averia/ArdCore/README.md

ArdCore, based on a project by www.20objects.com

ardcore_pcb
