averia/ArdCore/hardware/ardcore_V1/ardcore_esquematico.png

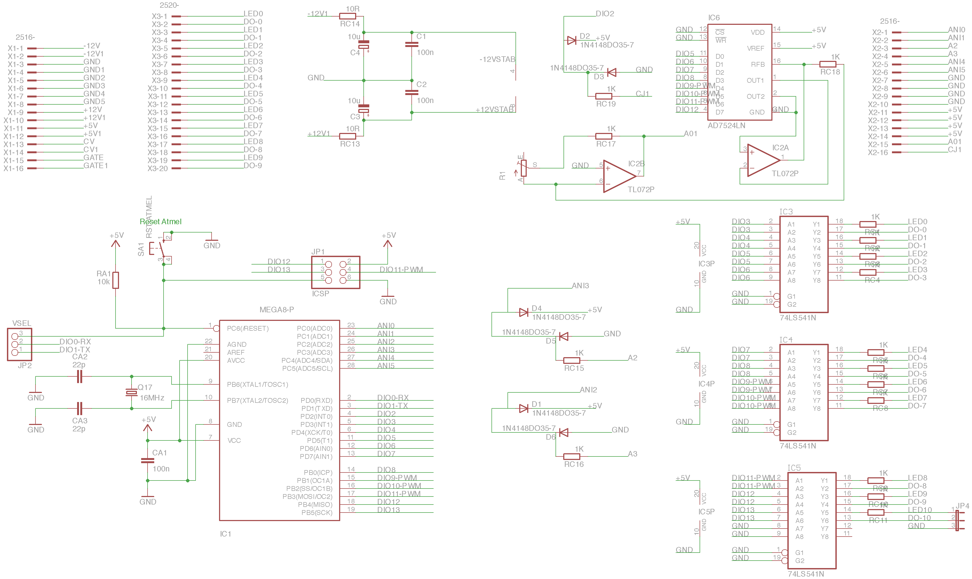
hardware/ardcore_V1/ardcore_esquematico.png
