averia/ArdCore/hardware/ardcore_V1/ardcore_V1.brd

## EAGLE design hardware/ardcore_V1/ardcore_V1.brd (2017-08-19)

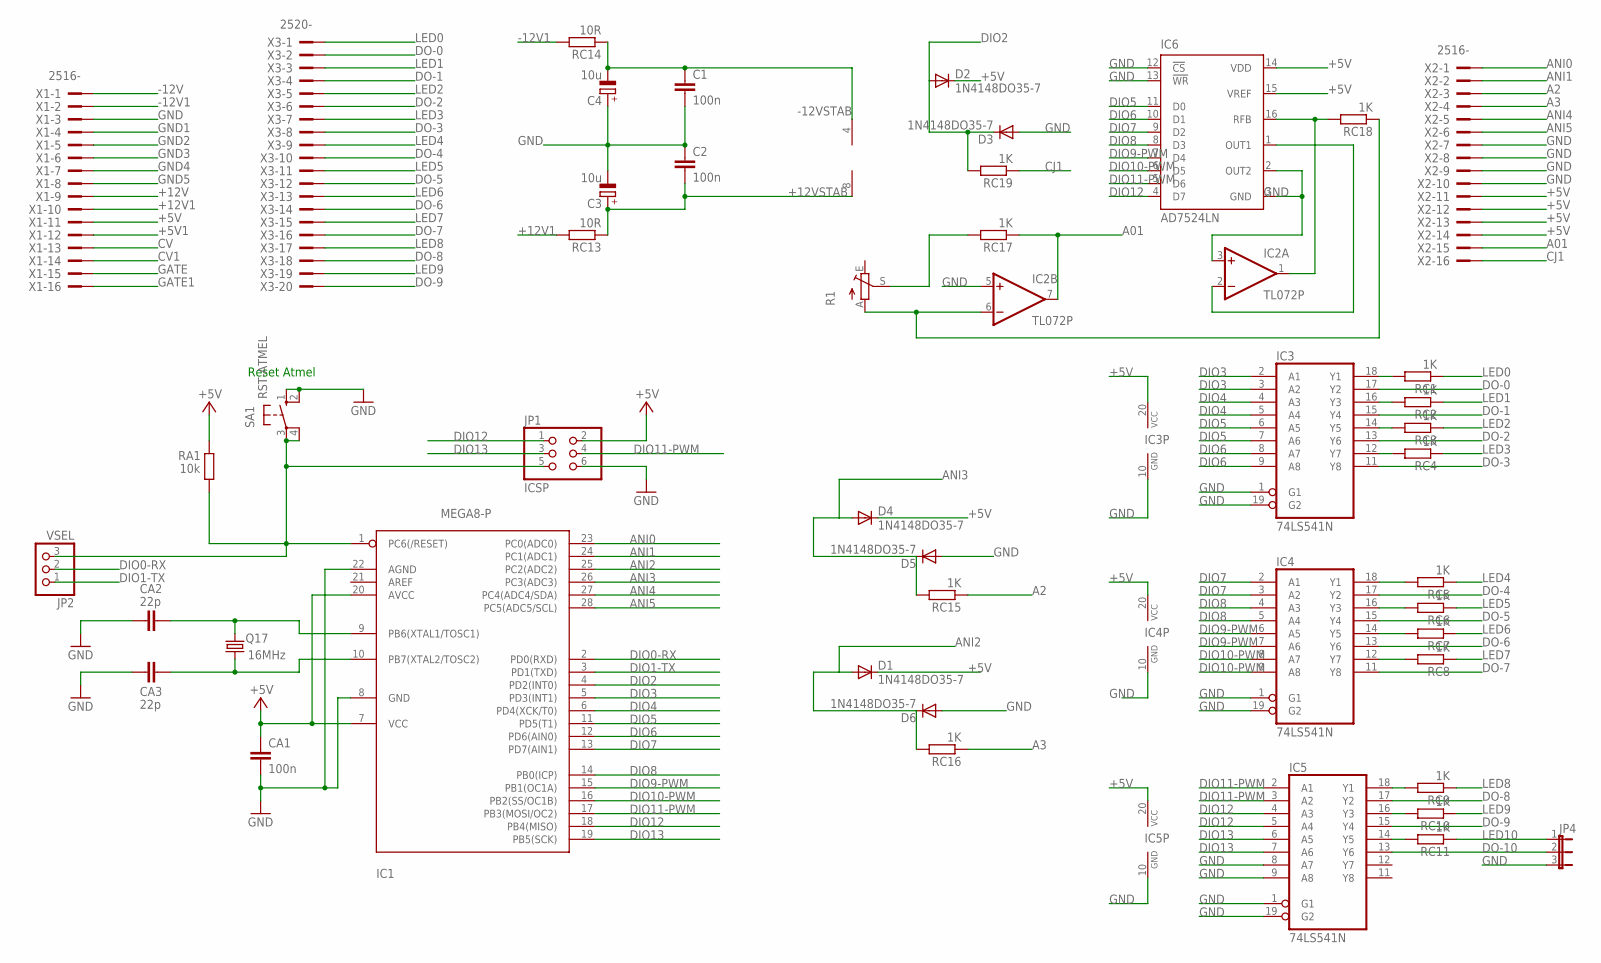
[picture p2: schematic ardcore_V1.sch]

Parts:
C1, C2: 100n; C050-025X075
C3, C4: 10u; E2,5-7
CA1: 100n; C050-025X075
CA2, CA3: 22p; C050-025X075
D1, D2, D3, D4, D5, D6: 1N4148DO35-7; DO35-7
IC1: MEGA8-P; DIL28-3
IC2: TL072P; DIL08
IC3, IC4, IC5: 74LS541N; DIL20
IC6: AD7524LN; DIL16
JP1: ICSP; 2X03
JP2: VSEL; 1X03
JP4: JP2E; JP2
Q17: 16MHz; HC49/S
R1: TRIM_EU-B64Y; B64Y
RA1: 10k; 0207/10
RC1, RC2, RC3, RC4, RC5, RC6, RC7, RC8, RC9, RC10, RC11, RC15, RC16, RC17, RC18, RC19: 1K; 0207/10
RC13, RC14: 10R; 0207/10
SA1: RST-ATMEL; B3F-10XX
X1, X2: 2516-; PAK100/2500-16
X3: 2520-; PAK100/2500-20

Connections:
+5V: CA1.1, D1.C, D2.C, D4.C, IC1.7 (VCC), IC1.20 (AVCC), IC3.20 (VCC), IC4.20 (VCC), IC5.20 (VCC), IC6.14 (VDD), IC6.15 (VREF), JP1.2, RA1.1, X1.11, X2.11, X2.12, X2.13, X2.14
+5V1: X1.12
+12V: X1.9
+12V1: RC13.2, X1.10
+12VSTAB: C2.2, C3.+, IC2.8 (V+), RC13.1
-12V: X1.1
-12V1: RC14.2, X1.2
-12VSTAB: C1.1, C4.-, IC2.4 (V-), RC14.1
A01: IC2.7 (OUT), RC17.1, X2.15
A2: RC15.1, X2.3
A3: RC16.1, X2.4
ANI0: IC1.23 (PC0(ADC0)), X2.1
ANI1: IC1.24 (PC1(ADC1)), X2.2
ANI2: D1.A, D6.C, IC1.25 (PC2(ADC2)), RC16.2
ANI3: D4.A, D5.C, IC1.26 (PC3(ADC3)), RC15.2
ANI4: IC1.27 (PC4(ADC4/SDA)), X2.5
ANI5: IC1.28 (PC5(ADC5/SCL)), X2.6
CJ1: RC19.1, X2.16
CV: X1.13
CV1: X1.14
DIO0-RX: IC1.2 (PD0(RXD)), JP2.2
DIO1-TX: IC1.3 (PD1(TXD)), JP2.1
DIO2: D2.A, D3.C, IC1.4 (PD2(INT0)), RC19.2
DIO3: IC1.5 (PD3(INT1)), IC3.2 (A1), IC3.3 (A2)
DIO4: IC1.6 (PD4(XCK/T0)), IC3.4 (A3), IC3.5 (A4)
DIO5: IC1.11 (PD5(T1)), IC3.6 (A5), IC3.7 (A6), IC6.11 (D0)
DIO6: IC1.12 (PD6(AIN0)), IC3.8 (A7), IC3.9 (A8), IC6.10 (D1)
DIO7: IC1.13 (PD7(AIN1)), IC4.2 (A1), IC4.3 (A2), IC6.9 (D2)
DIO8: IC1.14 (PB0(ICP)), IC4.4 (A3), IC4.5 (A4), IC6.8 (D3)
DIO9-PWM: IC1.15 (PB1(OC1A)), IC4.6 (A5), IC4.7 (A6), IC6.7 (D4)
DIO10-PWM: IC1.16 (PB2(SS/OC1B)), IC4.8 (A7), IC4.9 (A8), IC6.6 (D5)
DIO11-PWM: IC1.17 (PB3(MOSI/OC2)), IC5.2 (A1), IC5.3 (A2), IC6.5 (D6), JP1.4
DIO12: IC1.18 (PB4(MISO)), IC5.4 (A3), IC5.5 (A4), IC6.4 (D7), JP1.1
DIO13: IC1.19 (PB5(SCK)), IC5.6 (A5), IC5.7 (A6), JP1.3
DO-0: IC3.17 (Y2), X3.2
DO-1: IC3.15 (Y4), X3.4
DO-2: IC3.13 (Y6), X3.6
DO-3: IC3.11 (Y8), X3.8
DO-4: IC4.17 (Y2), X3.10
DO-5: IC4.15 (Y4), X3.12
DO-6: IC4.13 (Y6), X3.14
DO-7: IC4.11 (Y8), X3.16
DO-8: IC5.17 (Y2), X3.18
DO-9: IC5.15 (Y4), X3.20
DO-10: IC5.13 (Y6), JP4.2
GATE: X1.15
GATE1: X1.16
GND: C1.2, C2.1, C3.-, C4.+, CA1.2, CA2.2, CA3.2, D3.A, D5.A, D6.A, IC1.8 (GND), IC1.22 (AGND), IC2.3 (+IN), IC2.5 (+IN), IC3.1 (G1), IC3.10 (GND), IC3.19 (G2), IC4.1 (G1), IC4.10 (GND), IC4.19 (G2), IC5.1 (G1), IC5.8 (A7), IC5.9 (A8), IC5.10 (GND), IC5.19 (G2), IC6.2 (OUT2), IC6.3 (GND), IC6.12 (!CS), IC6.13 (!WR), JP1.6, JP4.3, SA1.1 (S), SA1.2 (S1), X1.3, X2.7, X2.8, X2.9, X2.10
GND1: X1.4
GND2: X1.5
GND3: X1.6
GND4: X1.7
GND5: X1.8
LED0: RC1.1, X3.1
LED1: RC2.1, X3.3
LED2: RC3.1, X3.5
LED3: RC4.1, X3.7
LED4: RC5.1, X3.9
LED5: RC6.1, X3.11
LED6: RC7.1, X3.13
LED7: RC8.1, X3.15
LED8: RC9.1, X3.17
LED9: RC10.1, X3.19
LED10: JP4.1, RC11.1
unnamed: IC3.18 (Y1), RC1.2
unnamed: IC3.16 (Y3), RC2.2
unnamed: IC3.14 (Y5), RC3.2
unnamed: CA2.1, IC1.9 (PB6(XTAL1/TOSC1)), Q17.2
unnamed: CA3.1, IC1.10 (PB7(XTAL2/TOSC2)), Q17.1
unnamed: IC3.12 (Y7), RC4.2
unnamed: IC4.18 (Y1), RC5.2
unnamed: IC4.16 (Y3), RC6.2
unnamed: IC4.14 (Y5), RC7.2
unnamed: IC4.12 (Y7), RC8.2
unnamed: IC5.18 (Y1), RC9.2
unnamed: IC5.16 (Y3), RC10.2
unnamed: IC5.14 (Y5), RC11.2
unnamed: IC2.6 (-IN), R1.A, RC18.1
unnamed: IC2.2 (-IN), IC6.1 (OUT1)
unnamed: R1.S, RC17.2
unnamed: IC2.1 (OUT), IC6.16 (RFB), RC18.2
RST: IC1.1 (PC6(/RESET)), JP1.5, JP2.3, RA1.2, SA1.3, SA1.4 (P1)

Notes on the sheet:
Reset Atmel

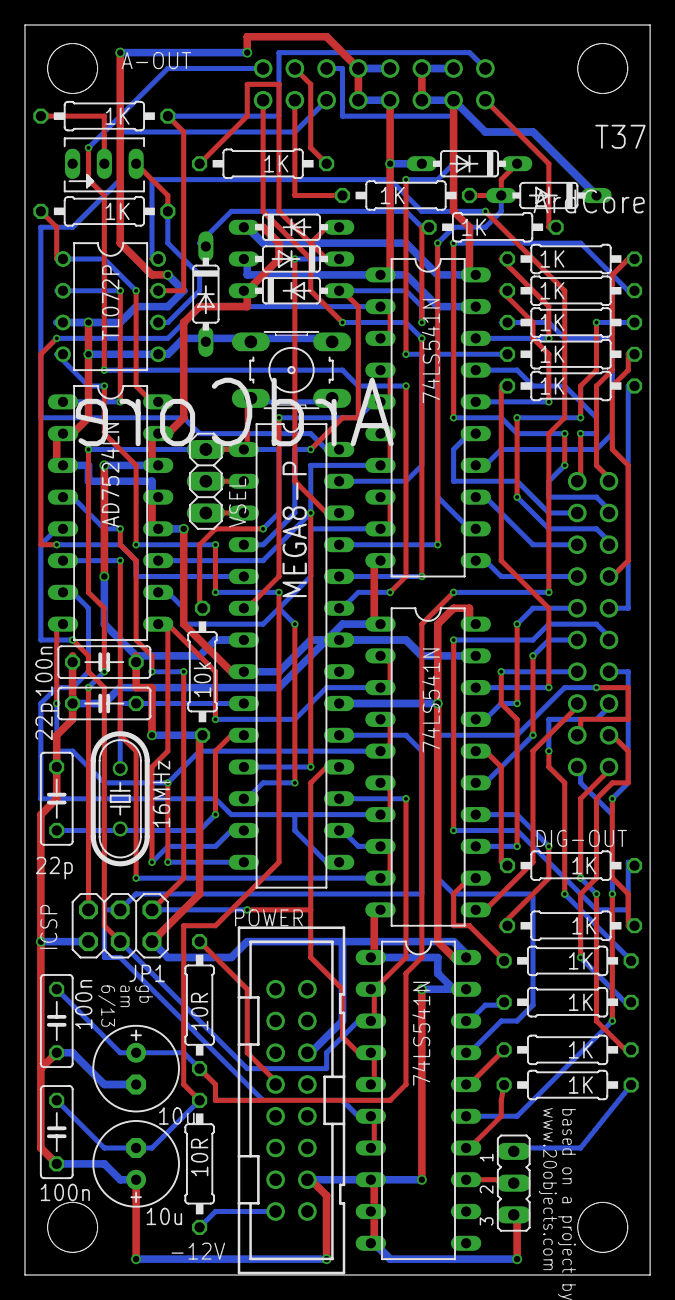
[picture p3: board ardcore_V1.brd from above]

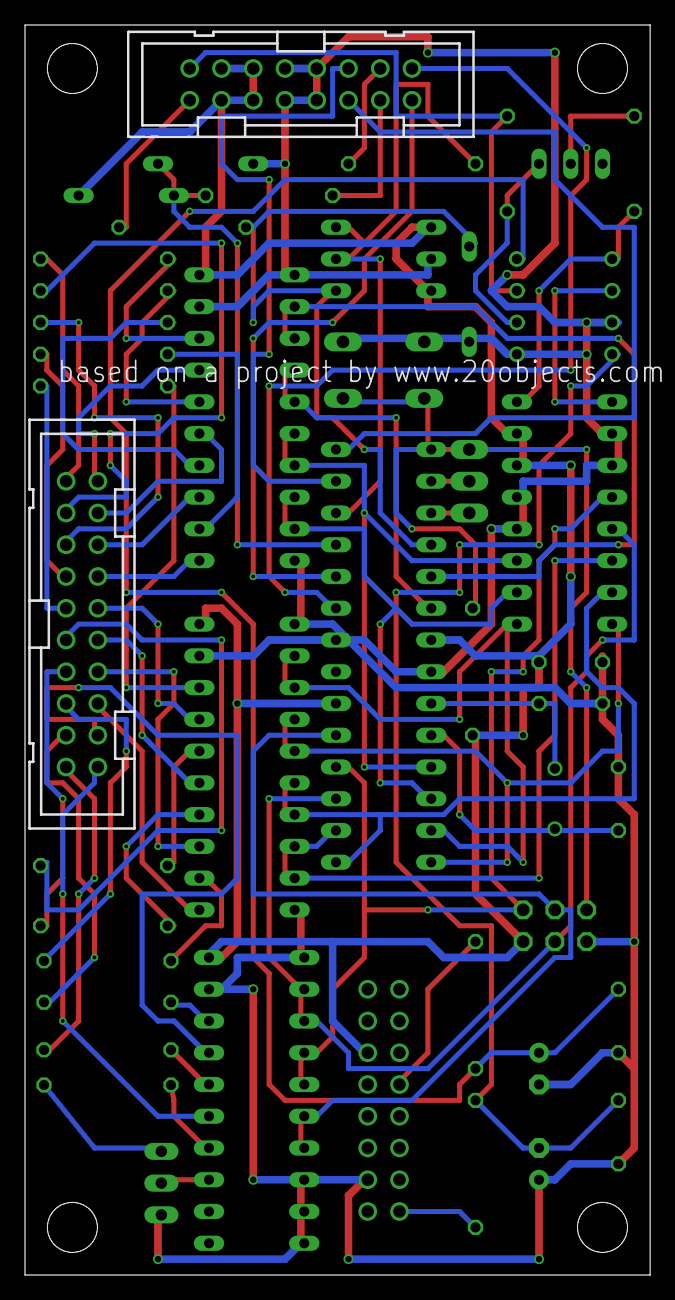
[picture p4: board ardcore_V1.brd from below]

Board: 4 copper layers, 50.0 x 100.0 mm, 47 parts (2 on the bottom side), 70 nets.
